lesash/Ormerod/stl/individual parts/modified carriage.stl

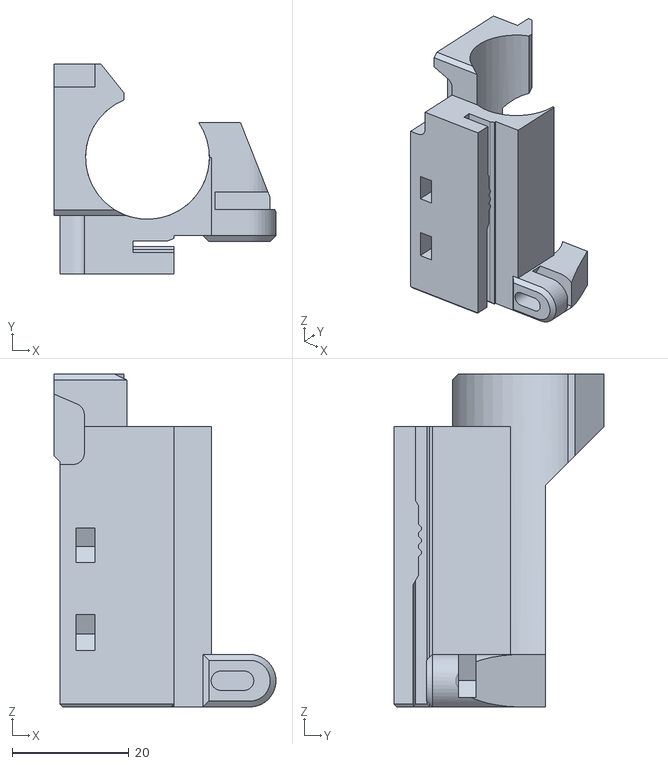
[picture p42: CAD file, 2014-04-15]
stl/individual parts/modified carriage.stl
38.0 x 36.0 x 57.0
