lesash/Ormerod/Upgrades/Duet-enclosure.stl

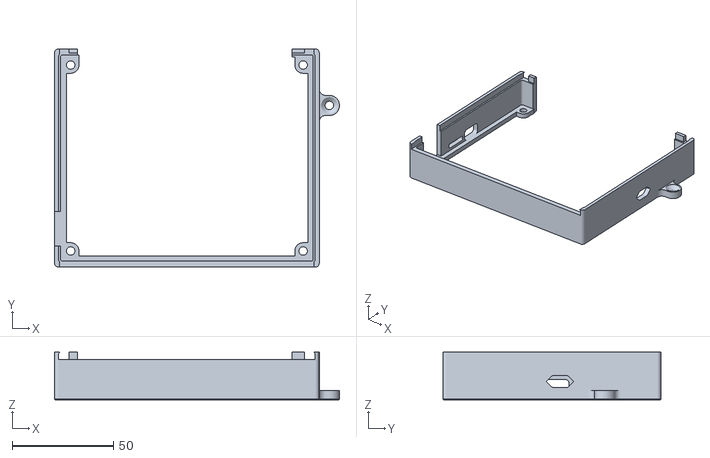
[picture p43: CAD file, 2014-05-24]
Upgrades/Duet-enclosure.stl
141.0 x 108.0 x 23.5
