lesash/Ormerod/Upgrades/Z-upper-mount2.stl

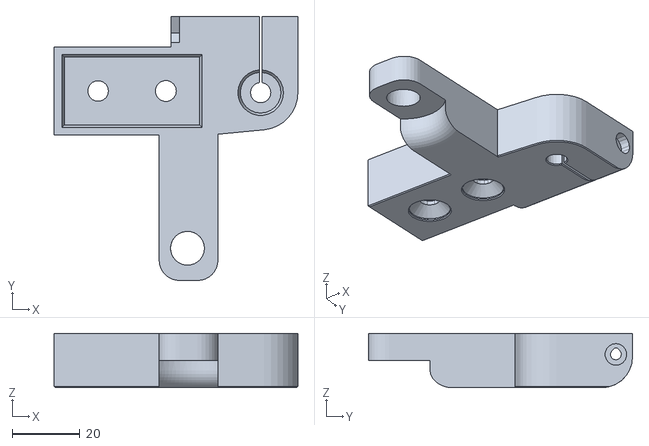
[picture p44: CAD file, 2014-04-21]
Upgrades/Z-upper-mount2.stl
72.0 x 78.0 x 16.0
