lesash/Ormerod/Upgrades/M5_Bar_top.stl

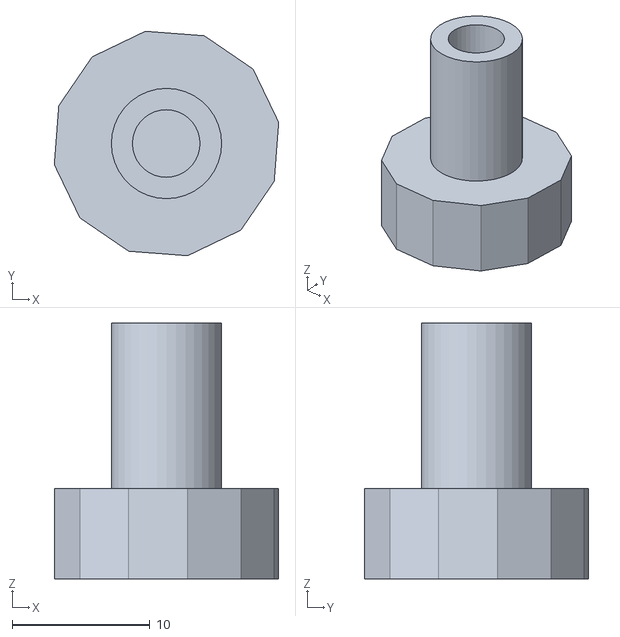
[picture p45: CAD file, 2014-04-21]
Upgrades/M5_Bar_top.stl
16.3 x 16.3 x 18.6
