lesash/Ormerod/Upgrades/Bed Plate.dxf

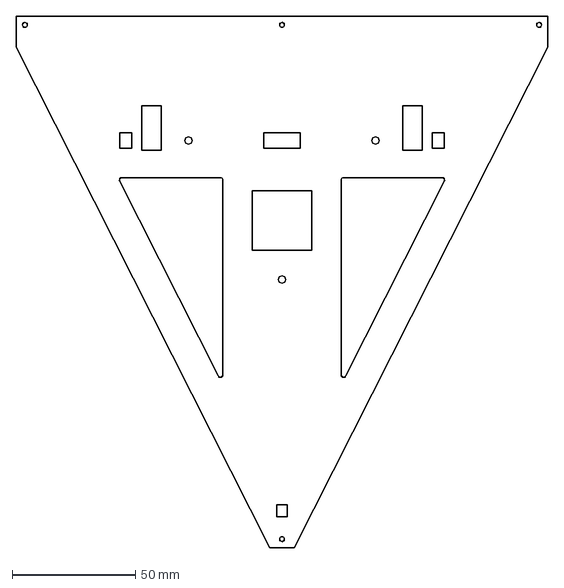
[picture p46: CAD file, 2014-04-18]
Upgrades/Bed Plate.dxf
216.0 x 216.0 mm
