lesash/Ormerod/Upgrades/Bed Front Cover.stl

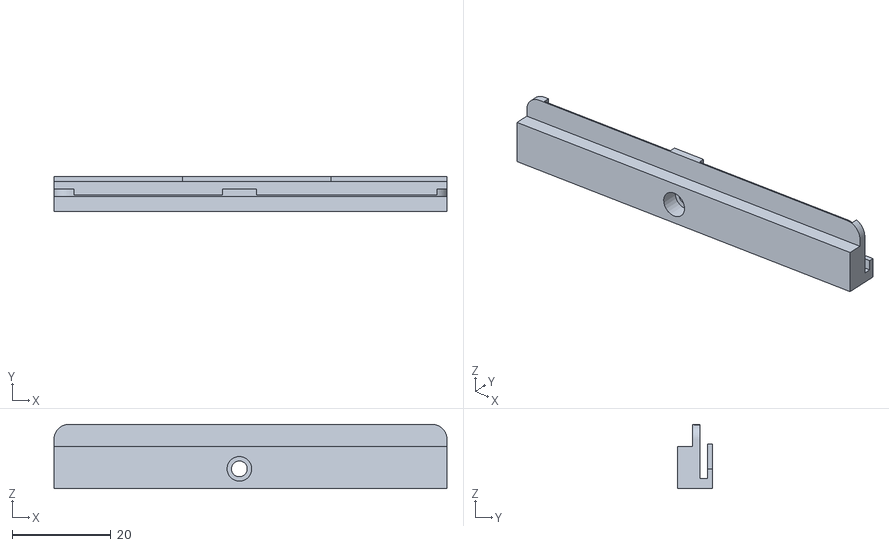
[picture p47: CAD file, 2014-04-18]
Upgrades/Bed Front Cover.stl
79.5 x 7.00 x 13.0
