lesash/Ormerod/Upgrades/front cover.stl

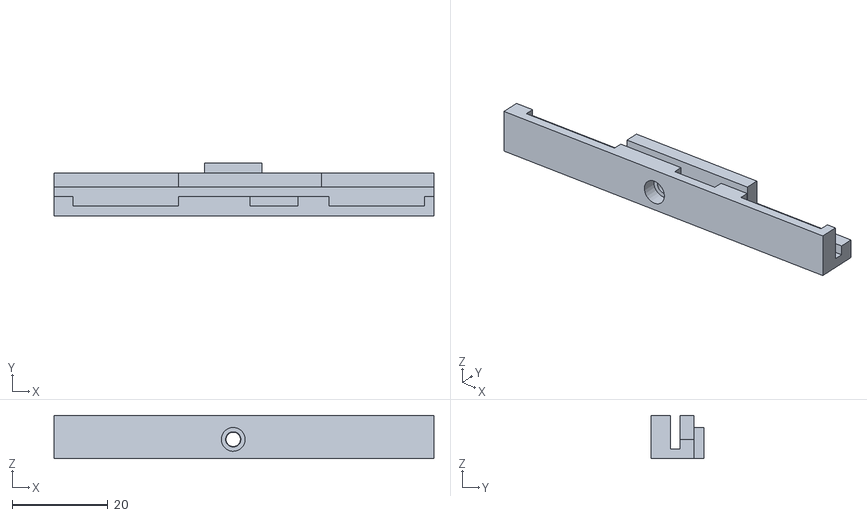
[picture p48: CAD file, 2014-04-18]
Upgrades/front cover.stl
79.5 x 11.0 x 9.00
