lesash/Ormerod/Upgrades/Front_support.stl

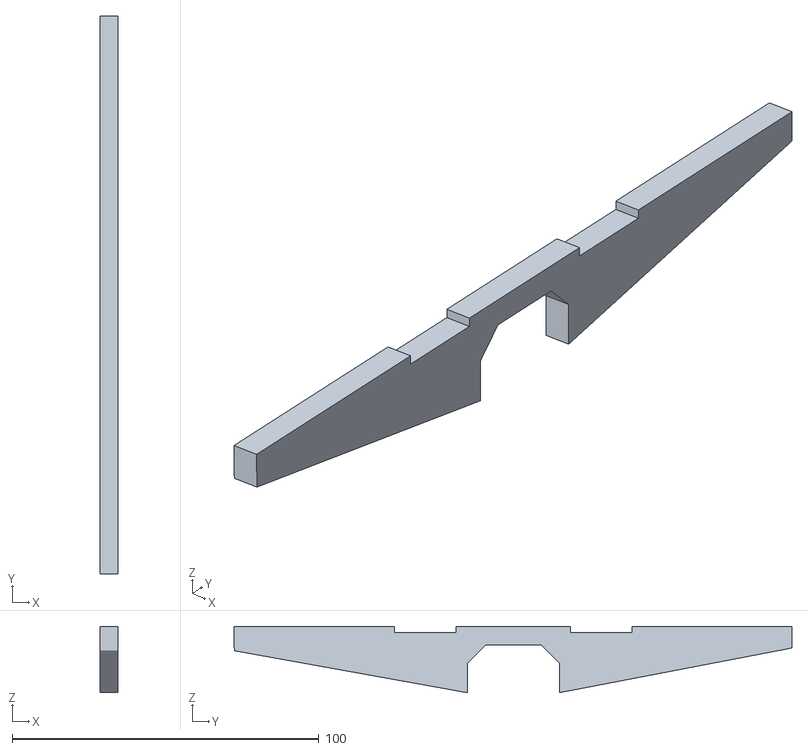
[picture p49: CAD file, 2014-04-18]
Upgrades/Front_support.stl
6.00 x 182.0 x 21.7
