lesash/Ormerod/Upgrades/fan_deflector_v4_2.stl

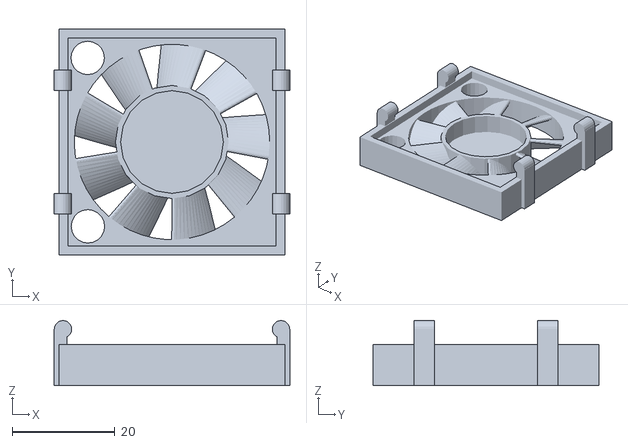
[picture p50: CAD file, 2014-04-18]
Upgrades/fan_deflector_v4_2.stl
45.9 x 44.0 x 12.6
