lesash/Ormerod/Upgrades/Cross_rib.stl

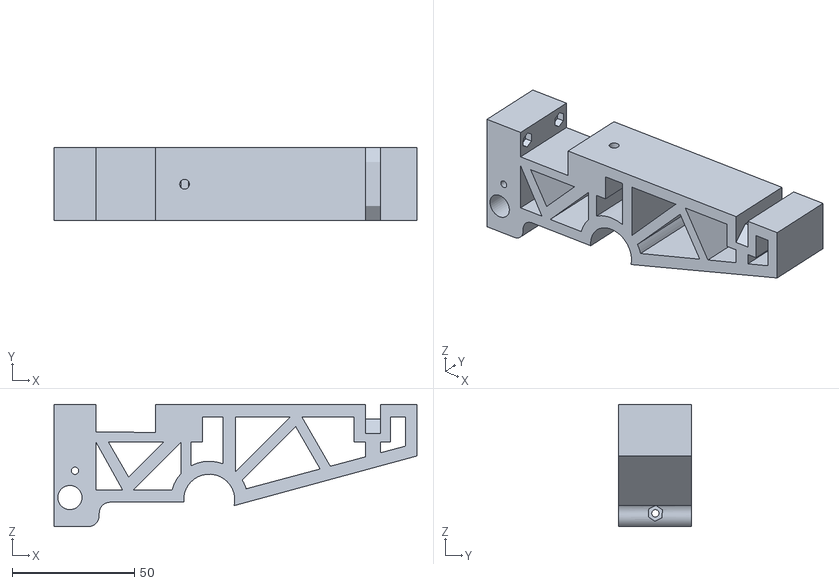
[picture p51: CAD file, 2014-04-18]
Upgrades/Cross_rib.stl
148.5 x 30.0 x 50.0
