lesash/Ormerod/Upgrades/TRIANGULAR BASEPLATE - with holes.dxf

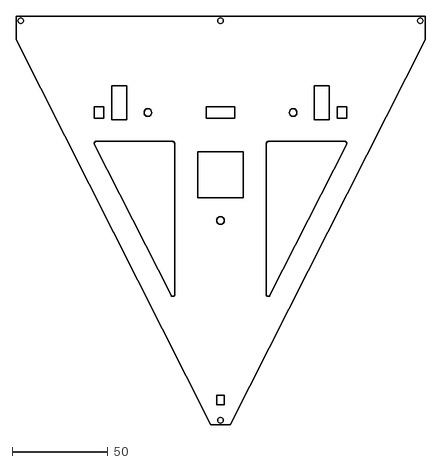
[picture p52: CAD file, 2014-04-18]
Upgrades/TRIANGULAR BASEPLATE - with holes.dxf
214.0 x 214.0
