lesash/Ormerod/Upgrades/Left_Belt_grip.stl

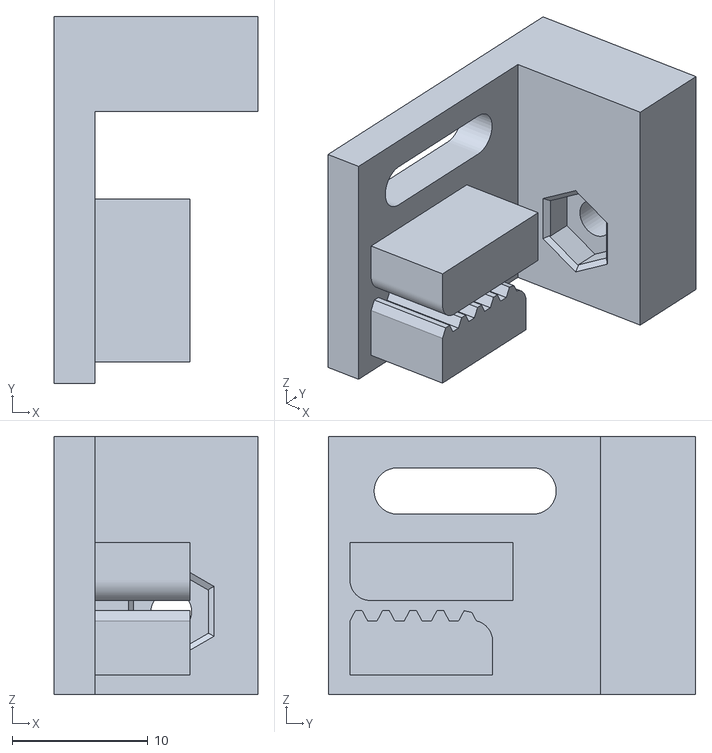
[picture p53: CAD file, 2014-04-15]
Upgrades/Left_Belt_grip.stl
15.0 x 27.0 x 19.0
