lesash/Ormerod/Upgrades/LHS_Bed_Support.stl

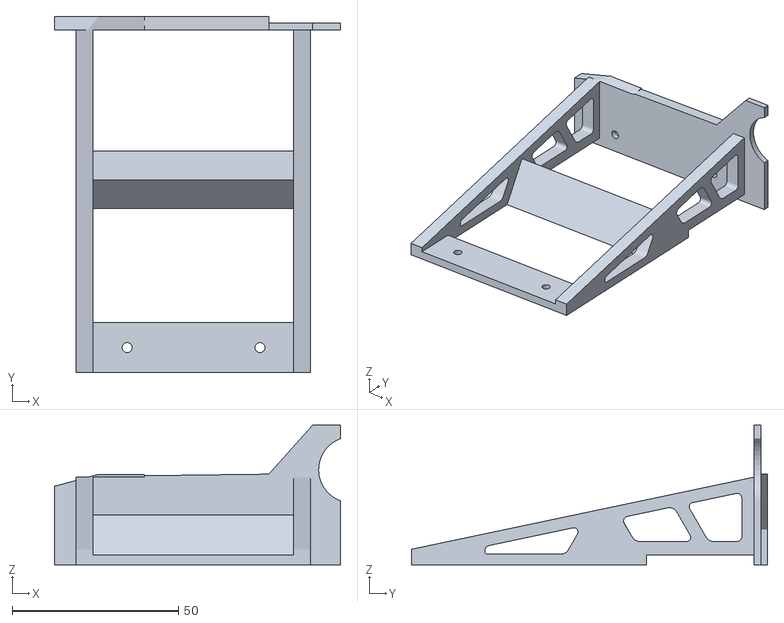
[picture p54: CAD file, 2014-04-15]
Upgrades/LHS_Bed_Support.stl
86.0 x 107.0 x 41.9
