lesash/Ormerod/Upgrades/Rear_cross_rib.stl

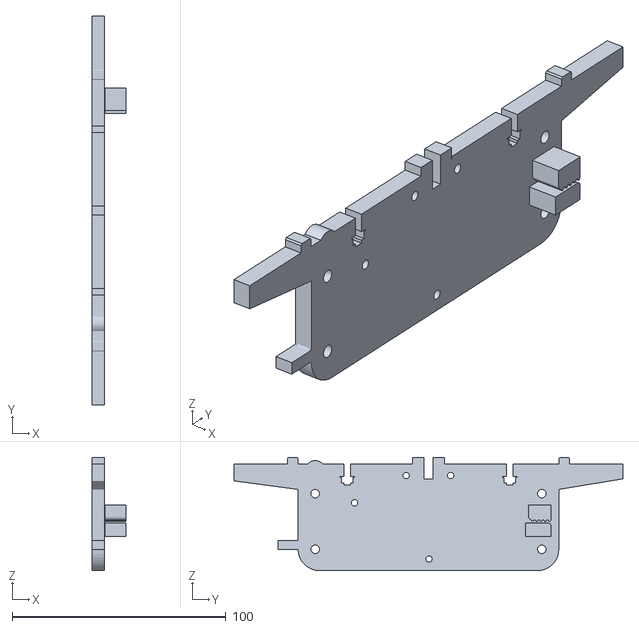
[picture p55: CAD file, 2014-04-15]
Upgrades/Rear_cross_rib.stl
16.0 x 182.0 x 53.0
