lesash/Ormerod/Upgrades/fan_deflector_v4_1.stl

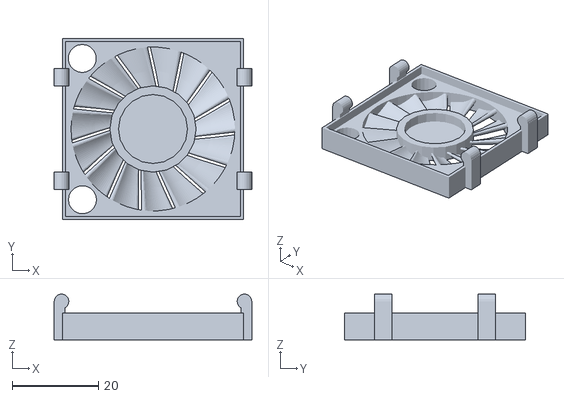
[picture p56: CAD file, 2014-04-18, an earlier design]
Upgrades/fan_deflector_v4_1.stl
45.9 x 42.0 x 10.6
