lesash/Ormerod/(list of files, cad)

Other CAD files:
Upgrades/due4x.skp
