lesash/Ormerod/documents/9 Heated bed wiring.pdf

## Heated bed wiring

Contents [hide]

- 1 Heated bed wiring harness
- 1.1 Preparing the heated bed end
- 1.2 Fitting the heated bed-end IDC connectors
- 1.3 Fitting the thermistor connector
- 1.4 Fitting the Duet-end IDC connector
- 1.5 The finished heated bed wiring harness
- 2 Fitting the bed wiring harness
- 3 Fit the print surface

## Heated bed wiring harness

The bed wiring harness provides power to the heated bed and carries the signal from the thermistor to the Duet board. You will need these parts:

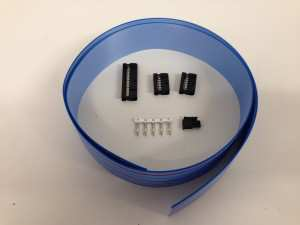
[picture p139: figure]

Component | Type | Quantity
Ribbon cable
26-way | Electronics 850mm

IDC 2×13
connector

Electronics 1

IDC 2×6
connector

Electronics 2

Female crimps
– 3030T-1 Electronics 2

Male 2-way
terminal –
3025-02

Electronics 1

Preparing the heated bed end

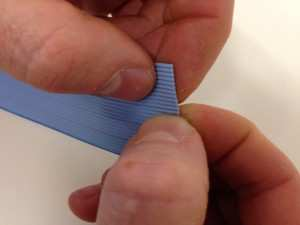
[picture p140: figure]

Start by splitting the ribbon cable to the correct lengths.

Split one end into 3 parts, down the length of the ribbon cable. You can simply tear the wires apart.

The outside two parts should be 12 wires each, leaving 2 wires in the centre. Split this back 160mm from the end.

Cut ONE of the 12-wire sections back 40mm. Cut the central 2 wires back 60mm from the end (sharp scissors are easiest for a straight cut).

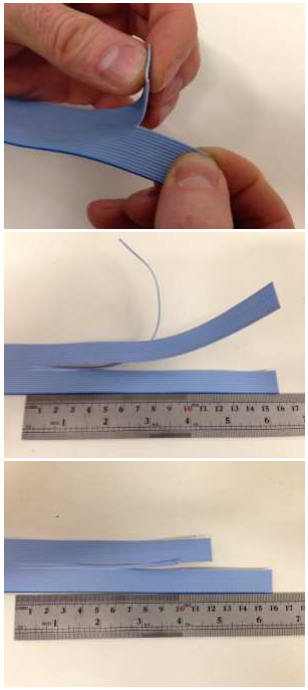
[picture p141: figure]

Fitting the heated bed-end IDC connectors

Connect the two IDC 2×6
connectors on the end of the two 12-way ends.

You can do this by hand; make sure the connector is square to the cable, and use a piece of wood to press on – it’s easier!

Make sure the connector is fully pushed down.

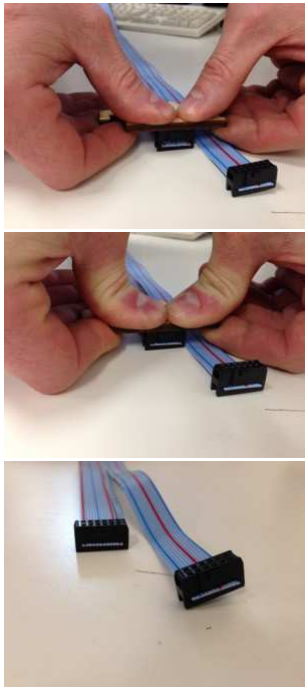
[picture p142: figure]

Fitting the thermistor connector

Strip 4mm of insulation from central 2 wires.

Crimp a female connector onto each one.

Insert the crimps into the crimp housing. Polarity isn’t important for the thermistor.

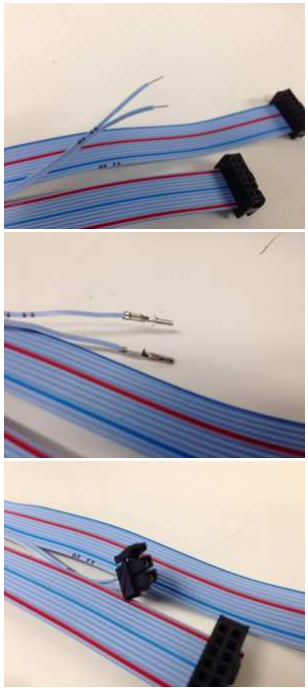
[picture p143: figure]

Fitting the Duet-end IDC connector

Cut the ribbon cable to 820mm, and connect the IDC 2×13
connector to the other end of the ribbon cable. It should face the other way from the IDC 2×6 connectors.

It’s easiest to do this in a vice.

Again, check that the cable is fully pushed into the connector.

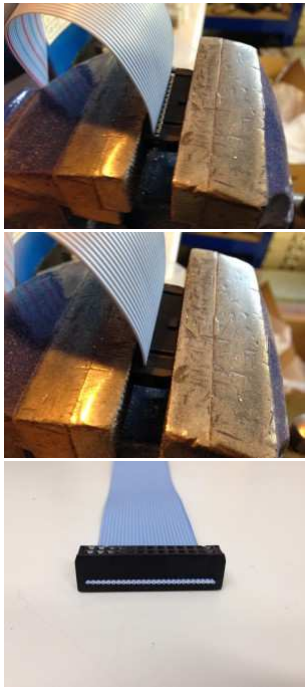
[picture p144: figure]

The finished heated bed wiring harness

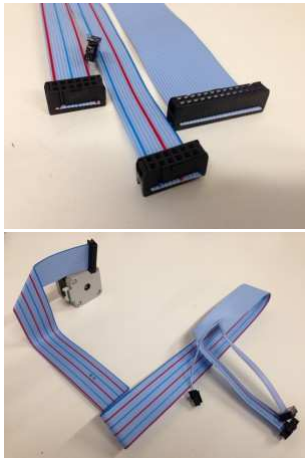
[picture p145: figure]

The finished heated bed wiring.

This is the rough layout of the wiring on the printer. The 2×13 IDC connector plugs into the Duet board, the 2×6 IDC connector plugs into the heated bed, and the central connector plugs into the thermistor in the centre of the heated bed.

## Fitting the bed wiring harness

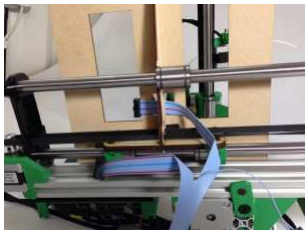
[picture p146: figure]

Start by turning over your printer. From underneath, thread the longest 12-way section of the bed wiring harness up through the central slot in the bed, then back down, as shown.

Make sure it reaches the cut out in the MDF bed, that it is designed for. Put a 45 degree bend in the cable. Thread the other shorter side up to the second slot.

Leave a good length of the main wire under the printer, and clip a loop of the ribbon cable into the slot near the Y axis motor.

Run the cable up the back of the machine, and bend it over to connect to the bed power pins on the Duet board, as shown.

CAUTION!

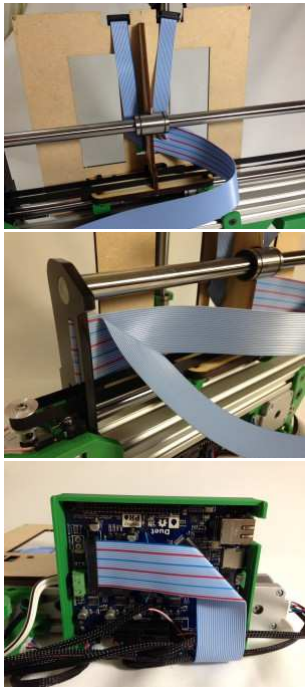
[picture p147: figure]

Pay particular attention when connecting the heated bed ribbon cable to the Duet board, as above. If you put it in the wrong place, 12V can run down the 3.3V line of the thermistor, and will immediately destroy the main processor when you turn it on. We regard this mistake as a user error, and is NOT covered by the warranty.

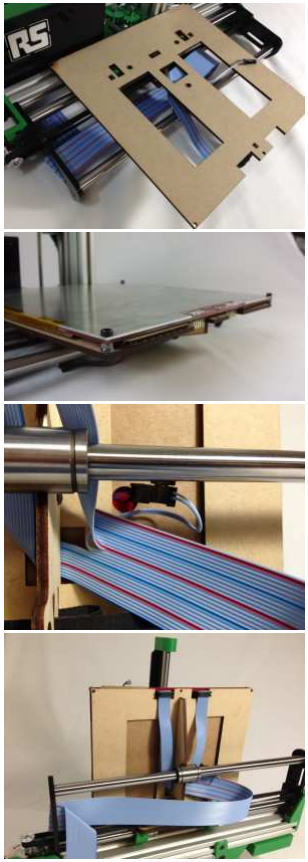
[picture p148: figure]

Adjust the ribbon cable as necessary to make it neat.

Put the heated bed, which you constructed in an earlier step, on the top of the Y carriage.

Make sure the thermistor wire is accessible underneath. Yours may be on the other side of the y-axis-rib, but it doesn’t matter. Plug the thermistor into the connector, which is attached to the central two wires of the ribbon cable. Tuck it into a position so it doesn’t rub on the linear rod.

Plug the two IDC connectors into the bottom of the heated bed PCB.

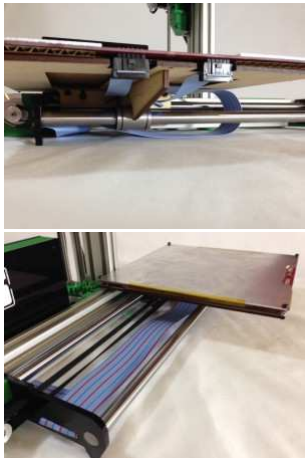
[picture p149: figure]

Finally, check that the movement of the Y axis allows the ribbon cable to fold neatly under the bed. Adjust as necessary.

Test with the Y carriage at the extremes of the axis.

## Fit the print surface

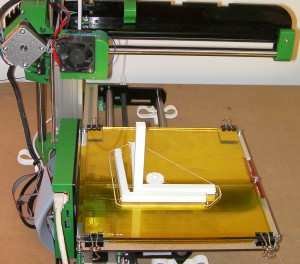
[picture p150: figure]

The print surface clips onto the heated bed using the four foldback clips. The glass plate is
rectangular, not square. Its long side should run along the Y axis, as on the completed printer shown here, otherwise the clips won’t hold the glass.
