lesash/Ormerod/(commit log)

2014-04-15 new Bed design
    WIP Bed design using RS DesignSpark Mech
    [Cross_rib.stl, LHS_Bed_Support.stl, LHS_Bes_Support.obj, Left_Belt_grip.stl, RHS_support.skp, RHS_support.step, Rear_cross_rib.stl, lhs_support.skp]
2014-04-18 New Bed design changed
    Printable bed support parts
    [Bed Front Cover.stl, Bed Plate.dxf, Cross_rib.stl, Front_support.stl, LHS_Bed_Support.stl, LHS_Bes_Support.obj, Left_Belt_grip.stl, RHS_support.skp]
2014-04-21 New Z axis top mount
    M5 threaded bar cover and new top mount
    [M5_Bar_top.stl, Z-upper-mount2.stl]
2014-05-24 Getting ready for the Due4X
    [Duet-enclosure.stl, due4x.skp]
2014-05-24 Duet4x in enclosure
